telec16/cardmeter/README.md

# Cardmeter

The pleasure of having a multimeter in your pocket !
