telec16/cardmeter/ltspice/frontend.asc

C1: cap; 100n
R1: res; 5k
R2: res; {Rdiv}
R3: res; 1
R4: res; 470k
R5: res; 100k
R6: res; 100k
R7: res; 100k
R8: res; 100k
R9: res; 100k
U1: AD8235
U2: LTC1992
V1: voltage; SINE(0 2 50)
V2: voltage; 3.3
V3: voltage; {Vref}
Named nets: 0, REF, vcc, out, out+, out-
.tran 100ms
.step param Vref list 0 .5 .75 1 1.25 1.5 1.85
.param Rdiv 10k
.param Vref 1.75
.step param Rdiv list 1k 10k
