telec16/cardmeter/ltspice/frontend_bis.asc

R1: res; 22k
R2: res; 10k
R3: res; 1
R4: res; 470k
R5: res; 100k
U1: AD8235
V1: voltage; SINE(0 2 50)
V2: voltage; 3.3
V3: voltage; {2.048/2}
Named nets: 0, vcc, out, out+, out-, REF
.tran 100ms
