telec16/cardmeter/kicad/cardV5.kicad_pcb

## KiCad design kicad/cardV5.kicad_pcb (2020-05-11)

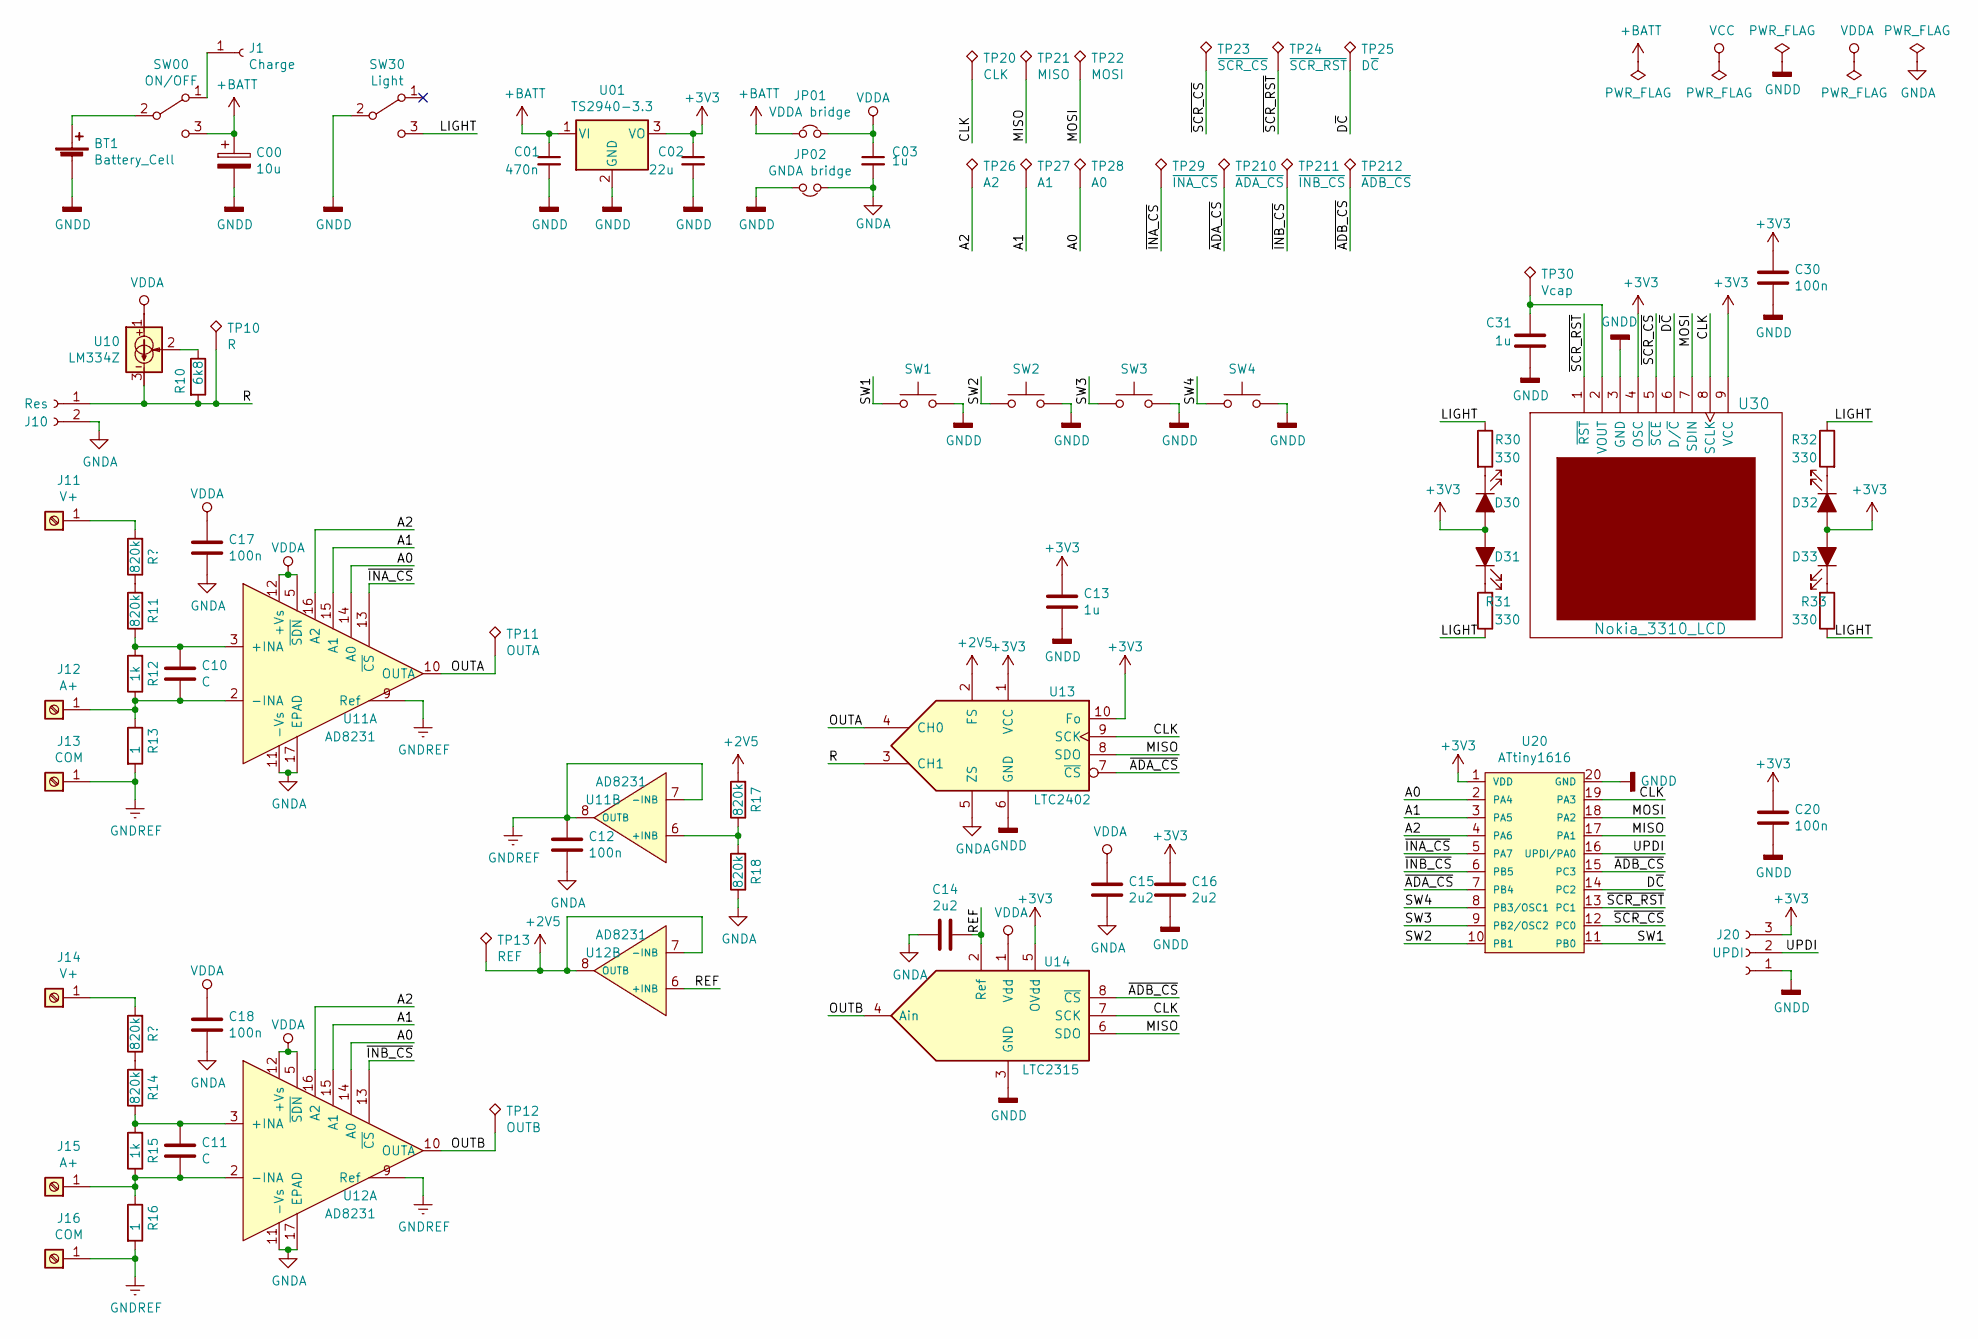
[picture p1: schematic cardV5.sch]

Parts:
BT1: Battery_Cell; LiPO_150m
C00: 10u; CP_Elec_3x5.4
C01: 470n; C_0805_2012Metric_Pad1.15x1.40mm_HandSolder
C02: 22u; C_0805_2012Metric_Pad1.15x1.40mm_HandSolder
C03, C31: 1u; C_0805_2012Metric_Pad1.15x1.40mm_HandSolder
C10, C11: C; C_0805_2012Metric_Pad1.15x1.40mm_HandSolder
C12, C17, C18, C20, C30: 100n; C_0805_2012Metric_Pad1.15x1.40mm_HandSolder
C13: 1u; C_1206_3216Metric_Pad1.42x1.75mm_HandSolder
C14, C15, C16: 2u2; C_1206_3216Metric_Pad1.42x1.75mm_HandSolder
D30, D31, D32, D33: LED_ALT; LED_0805_2012Metric_Pad1.15x1.40mm_HandSolder
J1: Charge; PinSocket_1x01_P2.54mm_Vertical
J10: Res; PinSocket_1x02_P2.54mm_Vertical
J11, J14: V+; Probing_pad
J12, J15: A+; Probing_pad
J13, J16: COM; Probing_pad
J20: UPDI; PinSocket_1x03_P2.54mm_Horizontal
JP01: VDDA bridge; SolderJumper-2_P1.3mm_Bridged_Pad1.0x1.5mm
JP02: GNDA bridge; SolderJumper-2_P1.3mm_Bridged_Pad1.0x1.5mm
R10: 6k8; R_0805_2012Metric_Pad1.15x1.40mm_HandSolder
R11, R14, R17, R18: 820k; R_0805_2012Metric_Pad1.15x1.40mm_HandSolder
R12, R15: 1k; R_0805_2012Metric_Pad1.15x1.40mm_HandSolder
R13, R16: 1; R_1210_3225Metric_Pad1.42x2.65mm_HandSolder
R30, R31, R32, R33: 330; R_0805_2012Metric_Pad1.15x1.40mm_HandSolder
SW00: ON/OFF; PinHeader_1x03_P2.54mm_Vertical
SW1, SW2, SW3, SW4: SW_Push; SW_SPST_EVQQ2
SW30: Light; PinHeader_1x03_P2.54mm_Vertical
TP10: R; Probing_pad
TP11: OUTA; Probing_pad
TP12: OUTB; Probing_pad
TP13: REF; Probing_pad
TP20: CLK; Probing_pad
TP21: MISO; Probing_pad
TP22: MOSI; Probing_pad
TP23: ~SCR_CS; Probing_pad
TP24: ~SCR_RST; Probing_pad
TP25: D~C; Probing_pad
TP26: A2; Probing_pad
TP27: A1; Probing_pad
TP28: A0; Probing_pad
TP29: ~INA_CS; Probing_pad
TP30: Vcap; Probing_pad
TP210: ~ADA_CS; Probing_pad
TP211: ~INB_CS; Probing_pad
TP212: ~ADB_CS; Probing_pad
U01: TS2940-3.3; SOT-223-3_TabPin2
U10: LM334Z; TO-92_Inline_Wide
U11, U12: AD8231; LFCSP-16-1EP_4x4mm_P0.65mm_EP2.1x2.1mm
U13: LTC2402; MSOP-10_3x3mm_P0.5mm
U14: LTC2315; TSOT-23-8_HandSoldering
U20: ATtiny1616; SOIC-20W_7.5x12.8mm_P1.27mm
U30: Nokia_3310_LCD; NOKIA_3310_LCD

Connections:
+2V5: R17.2, TP13.1, U12.7 (-INB), U12.8 (OUTB), U13.2 (FS)
+3V3: C02.1, C13.2, C16.2, C20.1, C30.1, D30.2 (A), D31.2 (A), D32.2 (A), D33.2 (A), J20.3, U01.3 (VO), U13.1 (VCC), U13.10 (Fo), U14.5 (OVdd), U20.1 (VDD), U30.4 (OSC), U30.9 (VCC)
+BATT: C00.1, C01.1, JP01.1, SW00.3 (C), U01.1 (VI)
/A0: TP28.1, U11.14 (A0), U12.14 (A0), U20.2 (PA4)
/A1: TP27.1, U11.15 (A1), U12.15 (A1), U20.3 (PA5)
/A2: TP26.1, U11.16 (A2), U12.16 (A2), U20.4 (PA6)
/CLK: TP20.1, U13.9 (SCK), U14.7 (SCK), U20.19 (PA3), U30.8 (SCLK)
/D~C: TP25.1, U20.14 (PC2), U30.6 (D/~C)
/LIGHT: R30.1, R31.1, R32.1, R33.1, SW30.3 (C)
/MISO: TP21.1, U13.8 (SDO), U14.6 (SDO), U20.17 (PA1)
/MOSI: TP22.1, U20.18 (PA2), U30.7 (SDIN)
/OUTA: TP11.1, U11.10 (OUTA), U13.4 (CH0)
/OUTB: TP12.1, U12.10 (OUTA), U14.4 (Ain)
/R: J10.1, R10.2, TP10.1, U10.3, U13.3 (CH1)
/REF: C14.1, U12.6 (+INB), U14.2 (Ref)
/SW1: SW1.1, U20.11 (PB0)
/SW2: SW2.1, U20.10 (PB1)
/SW3: SW3.1, U20.9 (PB2/OSC2)
/SW4: SW4.1, U20.8 (PB3/OSC1)
/UPDI: J20.2, U20.16 (UPDI/PA0)
/~ADA_CS: TP210.1, U13.7 (~CS), U20.7 (PB4)
/~ADB_CS: TP212.1, U14.8 (~CS), U20.15 (PC3)
/~INA_CS: TP29.1, U11.13 (~CS), U20.5 (PA7)
/~INB_CS: TP211.1, U12.13 (~CS), U20.6 (PB5)
/~SCR_CS: TP23.1, U20.12 (PC0), U30.5 (~SCE)
/~SCR_RST: TP24.1, U20.13 (PC1), U30.1 (~RST)
GNDA: C03.2, C12.2, C14.2, C15.1, C17.2, C18.2, J10.2, JP02.1, R18.1, U11.11 (-Vs), U11.17 (EPAD), U12.11 (-Vs), U12.17 (EPAD), U13.5 (ZS)
GNDD: BT1.2 (-), C00.2, C01.2, C02.2, C13.1, C16.1, C20.2, C30.2, C31.2, J20.1, JP02.2, SW1.2, SW2.2, SW3.2, SW4.2, SW30.2 (B), U01.2 (GND), U13.6 (GND), U14.3 (GND), U20.20 (GND), U30.3 (GND)
GNDREF: C12.1, J13.1, J16.1, R13.2, R16.2, U11.7 (-INB), U11.8 (OUTB), U11.9 (Ref), U12.9 (Ref)
unnamed: BT1.1 (+), SW00.2 (B)
unnamed: C10.1, R11.1, R12.2, U11.3 (+INA)
unnamed: C10.2, J12.1, R12.1, R13.1, U11.2 (-INA)
unnamed: C11.1, R14.1, R15.2, U12.3 (+INA)
unnamed: C11.2, J15.1, R15.1, R16.1, U12.2 (-INA)
unnamed: C31.1, TP30.1, U30.2 (VOUT)
unnamed: D30.1 (K), R30.2
unnamed: D31.1 (K), R31.2
unnamed: D32.1 (K), R32.2
unnamed: D33.1 (K), R33.2
unnamed: J1.1, SW00.1 (A)
unnamed: J11.1, R11.2
unnamed: J14.1, R14.2
unnamed: R10.1, U10.2
unnamed: R17.1, R18.2, U11.6 (+INB)
VDDA: C03.1, C15.2, C17.1, C18.1, JP01.2, U10.1, U11.5 (~SDN), U11.12 (+Vs), U12.5 (~SDN), U12.12 (+Vs), U14.1 (Vdd)

Board: 2 copper layers, 77 parts (10 on the bottom side), 45 nets, no tracks yet.
