telec16/cardmeter/kicad/cardV4.kicad_pcb

## KiCad design kicad/cardV4.kicad_pcb (2020-05-11, an earlier design)

Schematic: cardV4.sch

Parts:
BT1: Battery_Cell; BatteryHolder_Keystone_103_1x20mm
C00: 10u; CP_Elec_3x5.4
C01: 470n; C_0805_2012Metric_Pad1.15x1.40mm_HandSolder
C02: 22u; C_0805_2012Metric_Pad1.15x1.40mm_HandSolder
C03, C31: 1u; C_0805_2012Metric_Pad1.15x1.40mm_HandSolder
C04, C10, C11, C12, C20, C30: 100n; C_0805_2012Metric_Pad1.15x1.40mm_HandSolder
C13, C14: 33p; C_0805_2012Metric_Pad1.15x1.40mm_HandSolder
D30, D31, D32, D33: LED_ALT; LED_0805_2012Metric_Pad1.15x1.40mm_HandSolder
J1: Charge; PinSocket_1x01_P2.54mm_Vertical
J10: AOP; PinSocket_1x03_P1.27mm_Vertical
J11: Volt1; PinSocket_1x02_P2.54mm_Vertical
J12: Volt2; PinSocket_1x02_P2.54mm_Vertical
J13: Amp; PinSocket_1x02_P2.54mm_Vertical
J14: Res; PinSocket_1x02_P2.54mm_Vertical
J20: UPDI; PinSocket_1x03_P2.54mm_Horizontal
JP01: VDDA bridge; SolderJumper-2_P1.3mm_Bridged_Pad1.0x1.5mm
JP02: GNDA bridge; SolderJumper-2_P1.3mm_Bridged_Pad1.0x1.5mm
JP20, JP21, JP22: SolderJumper_2_Bridged; SolderJumper-2_P1.3mm_Bridged_Pad1.0x1.5mm
R10, R11: 100k; R_0805_2012Metric_Pad1.15x1.40mm_HandSolder
R12, R14: 820k; R_0805_2012Metric_Pad1.15x1.40mm_HandSolder
R13, R15: 1k; R_0805_2012Metric_Pad1.15x1.40mm_HandSolder
R16: 1; R_1210_3225Metric_Pad1.42x2.65mm_HandSolder
R17: 6k8; R_0805_2012Metric_Pad1.15x1.40mm_HandSolder
R30, R31, R32, R33: 330; R_0805_2012Metric_Pad1.15x1.40mm_HandSolder
SW00, SW30: ON/OFF; PinHeader_1x03_P2.54mm_Vertical
SW1, SW2, SW3, SW4: SW_Push; SW_SPST_EVQQ2
TP10: Ref; Probing_pad
TP11: V1; Probing_pad
TP12: V2; Probing_pad
TP14: R; Probing_pad
TP20: CLK; Probing_pad
TP21: MISO; Probing_pad
TP22: MOSI; Probing_pad
TP23: ~ADC_CS; Probing_pad
TP24: ~SCR_CS; Probing_pad
TP25: ~ADC_RST; Probing_pad
TP26: ~SCR_RST; Probing_pad
TP27: ~STANDBY; Probing_pad
TP28: ~RDY; Probing_pad
TP29: ~SYNC; Probing_pad
TP30: Vcap; Probing_pad
TP130: I+; Probing_pad
TP131: I-; Probing_pad
TP210: D~C; Probing_pad
U01: TS2940-3.3; SOT-223-3_TabPin2
U02: ADR291GT9Z; TO-92_Inline_Wide
U10: LT1178; SOIC-8_3.9x4.9mm_P1.27mm
U11: LM334Z; TO-92_Inline_Wide
U12: AD7731; SOIC-24W_7.5x15.4mm_P1.27mm
U20: ATtiny1616; SOIC-20W_7.5x12.8mm_P1.27mm
U30: Nokia_3310_LCD; NOKIA_3310_LCD
Y10: 4.9152MHz; Crystal_HC49-4H_Vertical

Connections:
+2V5: C04.1, U02.3, U12.14
+3V3: C02.1, C20.1, C30.1, D30.2 (A), D31.2 (A), D32.2 (A), D33.2 (A), J20.3, U01.3 (VO), U12.4, U12.23, U20.1 (VDD), U30.4 (OSC), U30.9 (VCC)
+BATT: C00.1, C01.1, JP01.1, SW00.3 (C), U01.1 (VI)
/CLK: TP20.1, U12.1, U20.19 (PA3), U30.8 (SCLK)
/D~C: TP210.1, U20.15 (PC3), U30.6 (D/~C)
/I+: J13.2, R16.1, TP130.1, U12.12
/I-: J13.1, R16.2, TP131.1, U12.13
/LIGHT: R30.1, R31.1, R32.1, R33.1, SW30.3 (C)
/MISO: TP21.1, U12.21, U20.17 (PA1)
/MOSI: TP22.1, U12.22, U20.18 (PA2), U30.7 (SDIN)
/R: J14.1, R17.2, TP14.1, U11.3, U12.16
/SW1: SW1.1, U20.11 (PB0)
/SW2: SW2.1, U20.10 (PB1)
/SW3: SW3.1, U20.9 (PB2/OSC2)
/SW4: SW4.1, U20.8 (PB3/OSC1)
/UPDI: J20.2, U20.16 (UPDI/PA0)
/V1: R12.2, R13.2, TP11.1, U12.10
/V2: R14.2, R15.2, TP12.1, U12.11
/~ADC_CS: TP23.1, U12.19, U20.3 (PA5)
/~ADC_RST: TP25.1, U12.6, U20.5 (PA7)
/~RDY: JP21.1 (A), TP28.1, U12.20
/~SCR_CS: TP24.1, U20.13 (PC1), U30.5 (~SCE)
/~SCR_RST: TP26.1, U20.14 (PC2), U30.1 (~RST)
/~STANDBY: JP22.1 (A), TP27.1, U12.18
/~SYNC: JP20.1 (A), TP29.1, U12.5
GNDA: C03.2, C04.2, C10.2, C11.2, C12.2, J14.2, JP02.1, R11.2, U02.2, U10.2, U12.8, U12.15, U12.17
GNDD: BT1.2 (-), C00.2, C01.2, C02.2, C13.1, C14.2, C20.2, C30.2, C31.2, J20.1, JP02.2, SW1.2, SW2.2, SW3.2, SW4.2, SW30.2 (B), U01.2 (GND), U12.24, U20.20 (GND), U30.3 (GND)
GNDREF: C11.1, J11.1, J12.2, R13.1, R15.1, TP10.1, U10.7, U10.8
unnamed: BT1.1 (+), SW00.2 (B)
unnamed: C13.2, U12.3, Y10.2
unnamed: C14.1, U12.2, Y10.1
unnamed: C31.1, TP30.1, U30.2 (VOUT)
unnamed: D30.1 (K), R30.2
unnamed: D31.1 (K), R31.2
unnamed: D32.1 (K), R32.2
unnamed: D33.1 (K), R33.2
unnamed: J1.1, SW00.1 (A)
unnamed: J10.1, U10.3
unnamed: J10.2, U10.4
unnamed: J10.3, U10.5
unnamed: J11.2, R12.1
unnamed: J12.1, R14.1
unnamed: JP20.2 (B), U20.6 (PB5)
unnamed: JP21.2 (B), U20.4 (PA6)
unnamed: JP22.2 (B), U20.2 (PA4)
unnamed: R10.2, R11.1, U10.1
unnamed: R17.1, U11.2
VDDA: C03.1, C10.1, C12.1, JP01.2, R10.1, U02.1, U10.6, U11.1, U12.9

Notes on the sheet:
Low-to-High Write Clock idle High
5pF
13pF

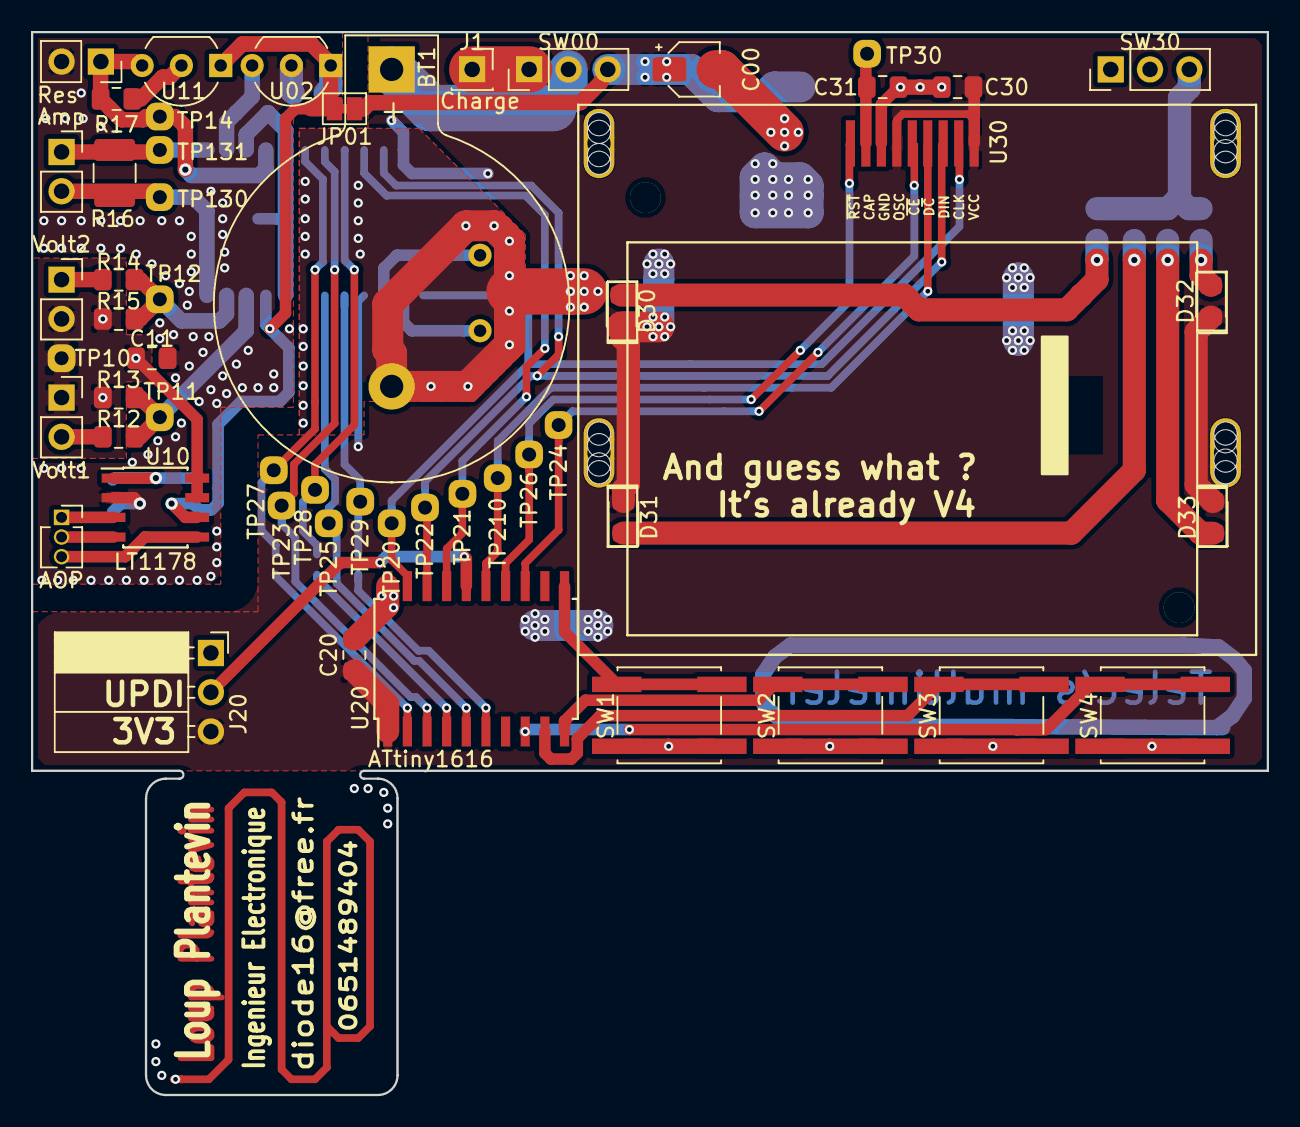
[picture p2: board cardV4.kicad_pcb from above]

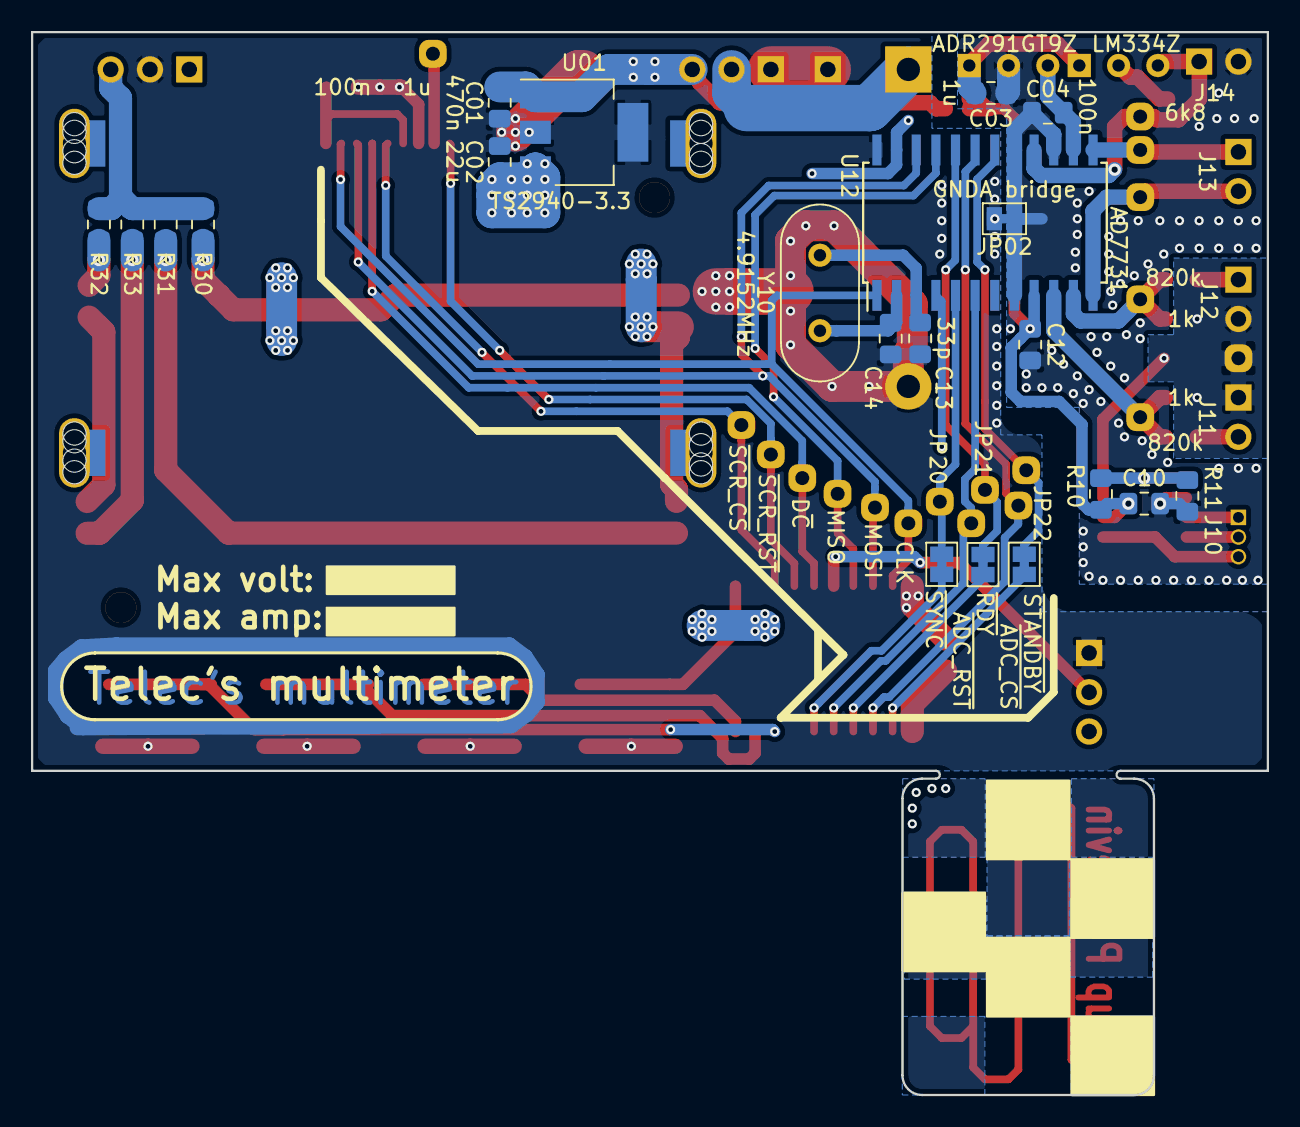
[picture p3: board cardV4.kicad_pcb from below]

Board: 2 copper layers, 79.9 x 68.7 mm, 74 parts (21 on the bottom side), 48 nets.
