telec16/cardmeter/kicad/CardMeterFrontEnd.kicad_pcb

## KiCad design kicad/CardMeterFrontEnd.kicad_pcb (2020-01-23)

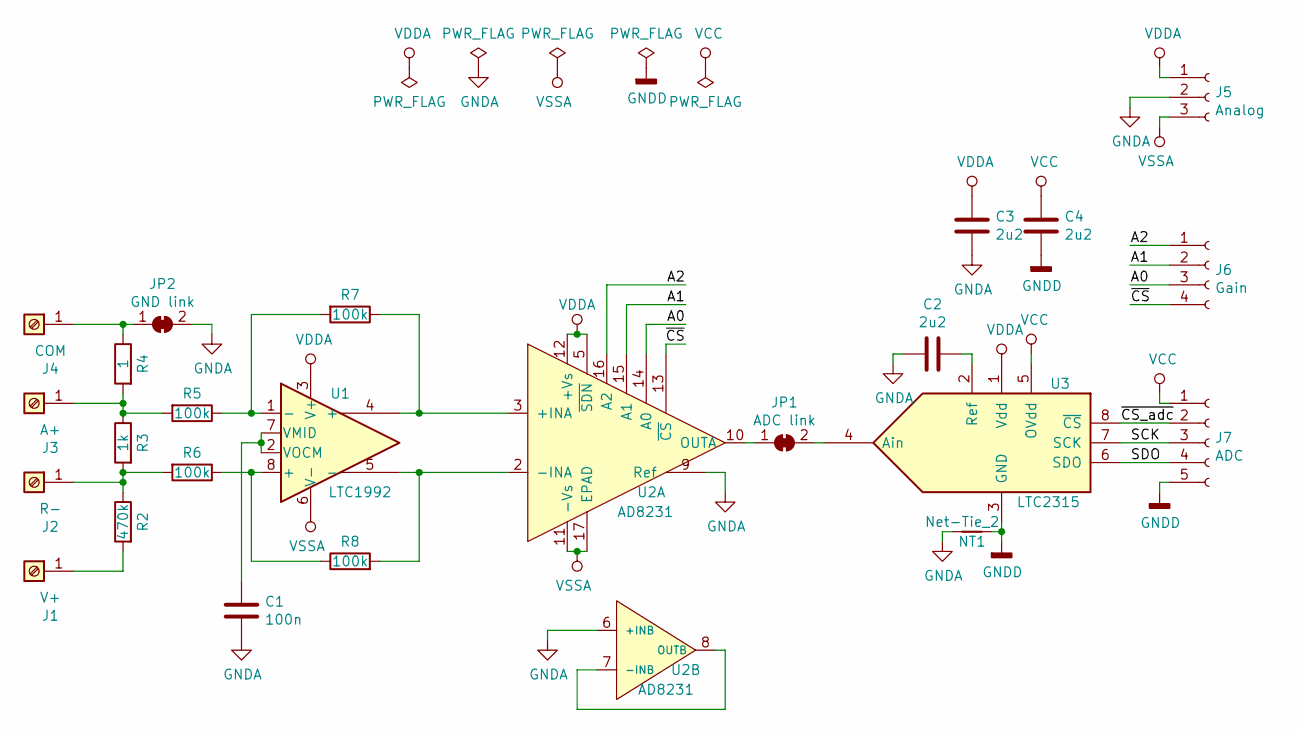
[picture p4: schematic CardMeterFrontEnd.sch]

Parts:
C1: 100n; C_0805_2012Metric_Pad1.15x1.40mm_HandSolder
C2, C3, C4: 2u2; C_1206_3216Metric_Pad1.42x1.75mm_HandSolder
J1: V+; Probing_pad
J2: R-; Probing_pad
J3: A+; Probing_pad
J4: COM; Probing_pad
J5: Analog; PinHeader_1x03_P1.27mm_Vertical
J6: Gain; PinHeader_1x04_P1.27mm_Vertical
J7: ADC; PinHeader_1x05_P1.27mm_Vertical
JP1: ADC link; SolderJumper-2_P1.3mm_Open_TrianglePad1.0x1.5mm
JP2: GND link; SolderJumper-2_P1.3mm_Open_TrianglePad1.0x1.5mm
NT1: Net-Tie_2; NetTie-2_SMD_Pad0.5mm
R2: 470k; R_0805_2012Metric_Pad1.15x1.40mm_HandSolder
R3: 1k; R_0805_2012Metric_Pad1.15x1.40mm_HandSolder
R4: 1; R_1206_3216Metric_Pad1.42x1.75mm_HandSolder
R5, R6, R7, R8: 100k; R_0805_2012Metric_Pad1.15x1.40mm_HandSolder
U1: LTC1992; MSOP-8_3x3mm_P0.65mm
U2: AD8231; LFCSP-16-1EP_4x4mm_P0.65mm_EP2.1x2.1mm
U3: LTC2315; TSOT-23-8_HandSoldering

Connections:
/A0: J6.3, U2.14 (A0)
/A1: J6.2, U2.15 (A1)
/A2: J6.1, U2.16 (A2)
/SCK: J7.3, U3.7 (SCK)
/SDO: J7.4, U3.6 (SDO)
/~CS: J6.4, U2.13 (~CS)
/~CS_adc: J7.2, U3.8 (~CS)
GNDA: C1.2, C2.2, C3.1, J5.2, JP2.2 (B), NT1.1, U2.6 (+INB), U2.9 (Ref)
GNDD: C4.1, J7.5, NT1.2, U3.3 (GND)
unnamed: C1.1, U1.2 (VOCM), U1.7 (VMID)
unnamed: C2.1, U3.2 (Ref)
unnamed: J1.1, R2.2
unnamed: J2.1, R2.1, R3.2, R6.2
unnamed: J3.1, R3.1, R4.2, R5.2
unnamed: J4.1, JP2.1 (A), R4.1
unnamed: JP1.1 (A), U2.10 (OUTA)
unnamed: JP1.2 (B), U3.4 (Ain)
unnamed: R5.1, R7.2, U1.1 (-)
unnamed: R6.1, R8.1, U1.8 (+)
unnamed: R7.1, U1.4 (+), U2.3 (+INA)
unnamed: R8.2, U1.5 (-), U2.2 (-INA)
unnamed: U2.7 (-INB), U2.8 (OUTB)
VCC: C4.2, J7.1, U3.5 (OVdd)
VDDA: C3.2, J5.1, U1.3 (V+), U2.5 (~SDN), U2.12 (+Vs), U3.1 (Vdd)
VSSA: J5.3, U1.6 (V-), U2.11 (-Vs), U2.17 (EPAD)

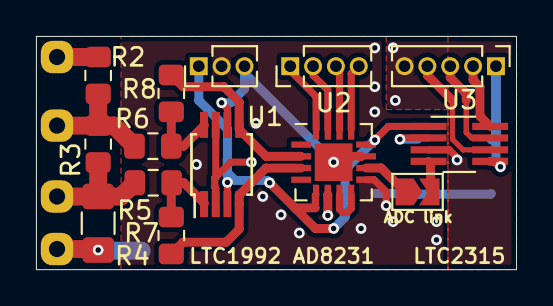
[picture p5: board CardMeterFrontEnd.kicad_pcb from above]

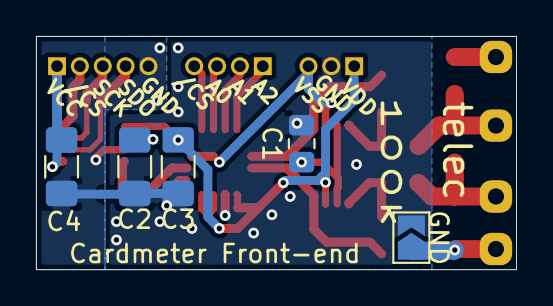
[picture p6: board CardMeterFrontEnd.kicad_pcb from below]

Board: 2 copper layers, 26.7 x 13.0 mm, 24 parts (6 on the bottom side), 25 nets.
