telec16/cardmeter/eagle/cardV2.brd

## EAGLE design eagle/cardV2.brd (2018-05-07, an earlier design)

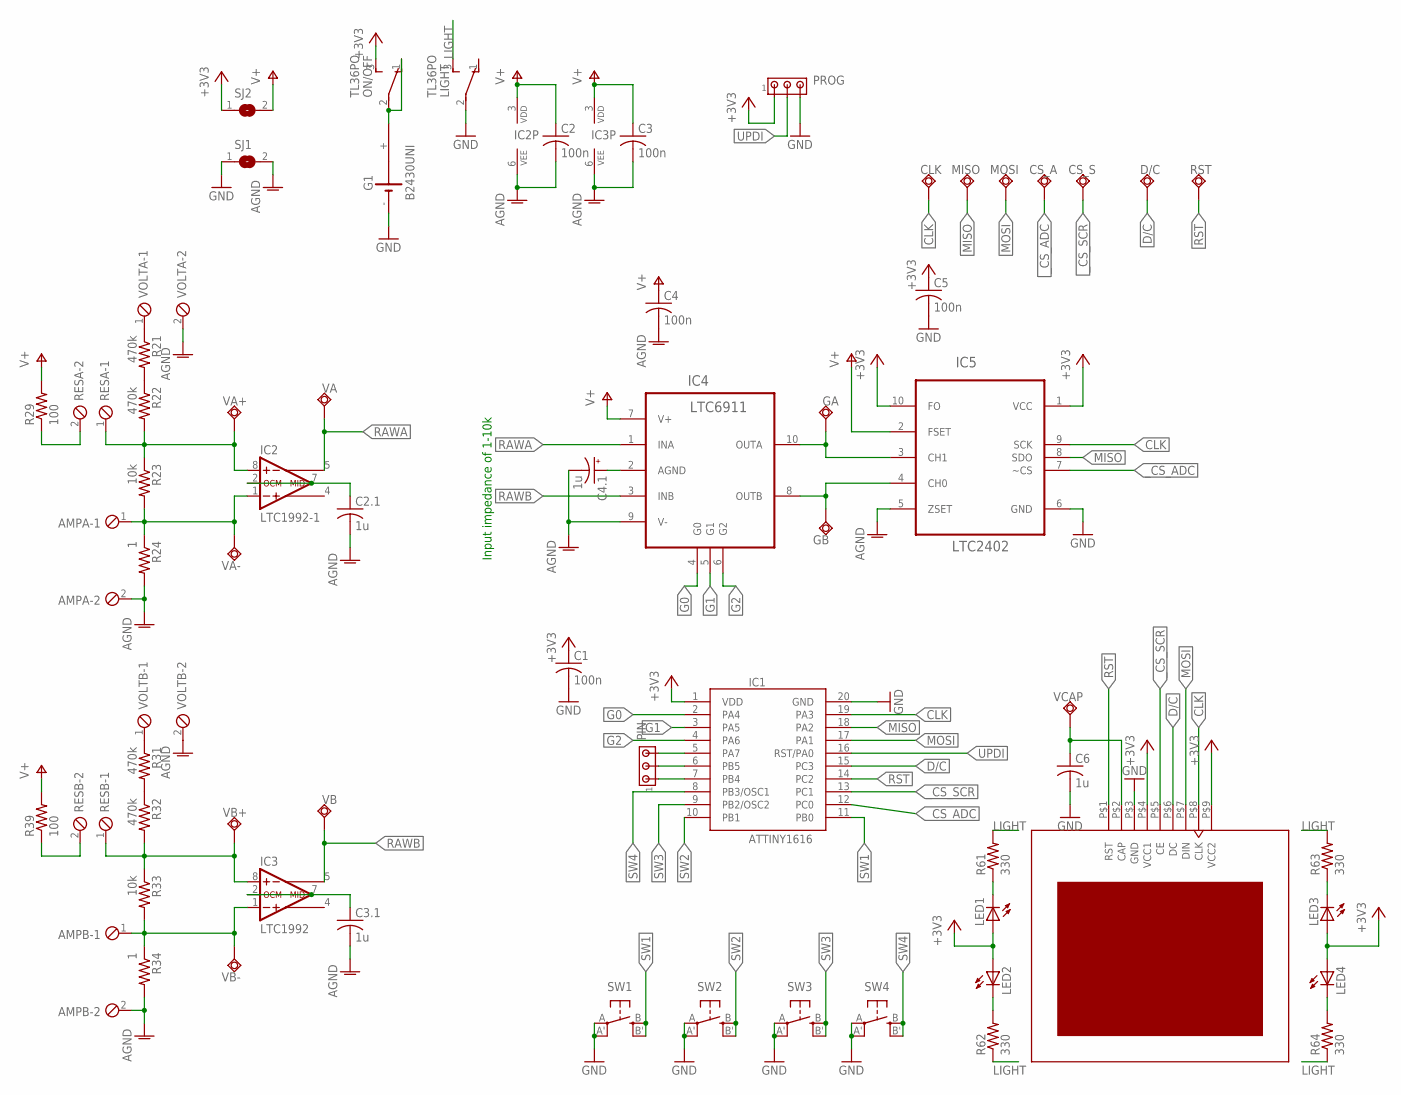
[picture p7: schematic cardV2.sch]

Parts:
AMPA: MPT2; 2POL254
AMPB: MPT2; 2POL254
C1, C2, C3, C4, C5: 100n; C0805K
C2.1, C3.1, C6: 1u; C0805
C4.1: 1u; A/3216-18R
CLK: TPSQB1,27; B1,27
CS_A: TPSQB1,27; B1,27
CS_S: TPSQB1,27; B1,27
D/C: TPSQB1,27; B1,27
G1: B2430UNI
GA: TPSQB1,27; B1,27
GB: TPSQB1,27; B1,27
IC1: ATTINY1616; SO20W
IC2: LTC1992-1; MSOP8
IC3: LTC1992; MSOP8
IC4: LTC6911; MSOP10
IC5: LTC2402; MSOP10
LED1, LED2, LED3, LED4: LEDCHIP-LED0805; CHIP-LED0805
LIGHT: TL36PO; TL3XPO
MISO: TPSQB1,27; B1,27
MOSI: TPSQB1,27; B1,27
ON/OFF: TL36PO; TL3XPO
PIN: MTA03-100; 10X03MTA
PROG: MTA03-100; 10X03MTA
R21, R22, R31, R32: 470k; M0805
R23, R33: 10k; M0805
R24, R34: 1; M0805
R29, R39: 100; M0805
R61, R62, R63, R64: 330; M0805
RESA: MPT2; 2POL254
RESB: MPT2; 2POL254
RST: TPSQB1,27; B1,27
SJ1, SJ2: SJ
SW1, SW2, SW3, SW4: SPST_TACT-EVQQ2; EVQ-Q2
U$1: NOKIA_SCREEN
VA: TPSQB1,27; B1,27
VA+: TPSQB1,27; B1,27
VA-: TPSQB1,27; B1,27
VB: TPSQB1,27; B1,27
VB+: TPSQB1,27; B1,27
VB-: TPSQB1,27; B1,27
VCAP: TPSQB1,27; B1,27
VOLTA: MPT2; 2POL254
VOLTB: MPT2; 2POL254

Connections:
+3V3: C1.1, C5.1, IC1.1 (VDD), IC5.1 (VCC), IC5.10 (FO), LED1.A, LED2.A, LED3.A, LED4.A, ON/OFF.3 (S), PROG.1, SJ2.1, U$1.P$4 (VCC1), U$1.P$9 (VCC2)
AGND: AMPA.2, AMPB.2, C2.2, C2.1.2, C3.2, C3.1.2, C4.2, C4.1.-, IC2.6 (VEE), IC3.6 (VEE), IC4.9 (V-), IC5.5 (ZSET), R24.2, R34.2, SJ1.2, VOLTA.2, VOLTB.2
CLK: CLK.TP, IC1.19 (PA3), IC5.9 (SCK), U$1.P$8 (CLK)
D/C: D/C.TP, IC1.15 (PC3), U$1.P$6 (DC)
G0: IC1.2 (PA4), IC4.4 (G0)
G1: IC1.3 (PA5), IC4.5 (G1)
G2: IC1.4 (PA6), IC4.6 (G2)
GND: C1.2, C5.2, C6.2, G1.-, IC1.20 (GND), IC5.6 (GND), LIGHT.2, PROG.3, SJ1.1, SW1.A, SW1.A' (P1), SW2.A, SW2.A' (P1), SW3.A, SW3.A' (P1), SW4.A, SW4.A' (P1), U$1.P$3 (GND)
LIGHT: LIGHT.3 (S), R61.2, R62.1, R63.2, R64.1
MISO: IC1.18 (PA2), IC5.8 (SDO), MISO.TP
MOSI: IC1.17 (PA1), MOSI.TP, U$1.P$7 (DIN)
unnamed: G1.+, ON/OFF.1 (O), ON/OFF.2
unnamed: LED1.C, R61.1
unnamed: C6.1, U$1.P$2 (CAP), VCAP.TP
unnamed: LED2.C, R62.2
unnamed: LED4.C, R64.2
unnamed: LED3.C, R63.1
unnamed: IC1.7 (PB4), PIN.1
unnamed: IC1.5 (PA7), PIN.3
unnamed: IC1.6 (PB5), PIN.2
unnamed: AMPA.1, IC2.1 (-IN), R23.2, R24.1, VA-.TP
unnamed: IC2.8 (+IN), R22.2, R23.1, RESA.1, VA+.TP
unnamed: C4.1.+, IC4.2 (AGND)
unnamed: C2.1.1, IC2.2 (OCM), IC2.7 (MID)
unnamed: R21.2, R22.1
unnamed: AMPB.1, IC3.1 (-IN), R33.2, R34.1, VB-.TP
unnamed: IC3.8 (+IN), R32.2, R33.1, RESB.1, VB+.TP
unnamed: R21.1, VOLTA.1
unnamed: R29.1, RESA.2
unnamed: GB.TP, IC4.8 (OUTB), IC5.4 (CH0)
unnamed: C3.1.1, IC3.2 (OCM), IC3.7 (MID)
unnamed: R31.2, R32.1
unnamed: R31.1, VOLTB.1
unnamed: R39.1, RESB.2
unnamed: GA.TP, IC4.10 (OUTA), IC5.3 (CH1)
RAWA: IC2.5 (-OUT), IC4.1 (INA), VA.TP
RAWB: IC3.5 (-OUT), IC4.3 (INB), VB.TP
RST: IC1.14 (PC2), RST.TP, U$1.P$1 (RST)
SW1: IC1.11 (PB0), SW1.B (S), SW1.B' (S1)
SW2: IC1.10 (PB1), SW2.B (S), SW2.B' (S1)
SW3: IC1.9 (PB2/OSC2), SW3.B (S), SW3.B' (S1)
SW4: IC1.8 (PB3/OSC1), SW4.B (S), SW4.B' (S1)
UPDI: IC1.16 (RST/PA0), PROG.2
V+: C2.1, C3.1, C4.1, IC2.3 (VDD), IC3.3 (VDD), IC4.7 (V+), IC5.2 (FSET), R29.2, R39.2, SJ2.2
_CS_ADC: CS_A.TP, IC1.12 (PC0), IC5.7 (~CS)
_CS_SCR: CS_S.TP, IC1.13 (PC1), U$1.P$5 (CE)

Notes on the sheet:
Input impedance of 1-10k

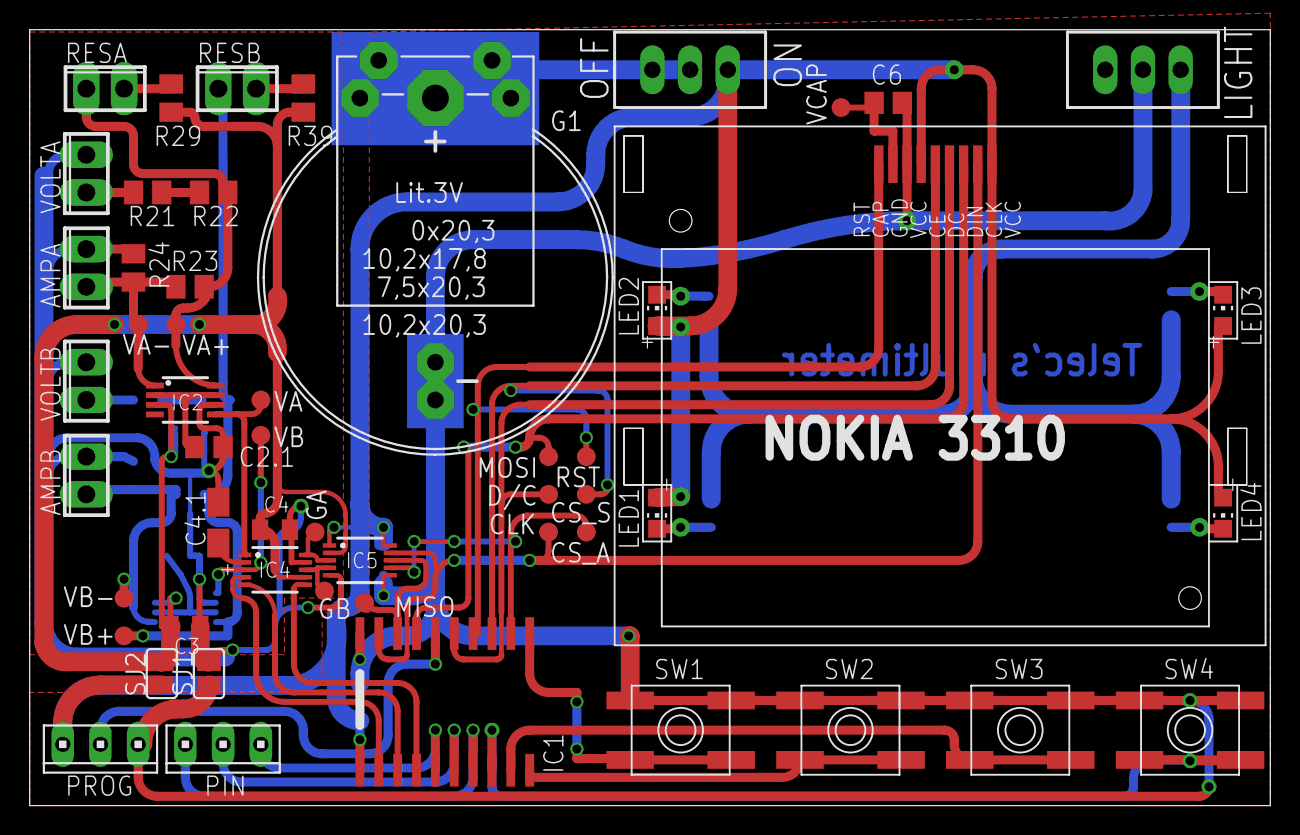
[picture p8: board cardV2.brd from above]

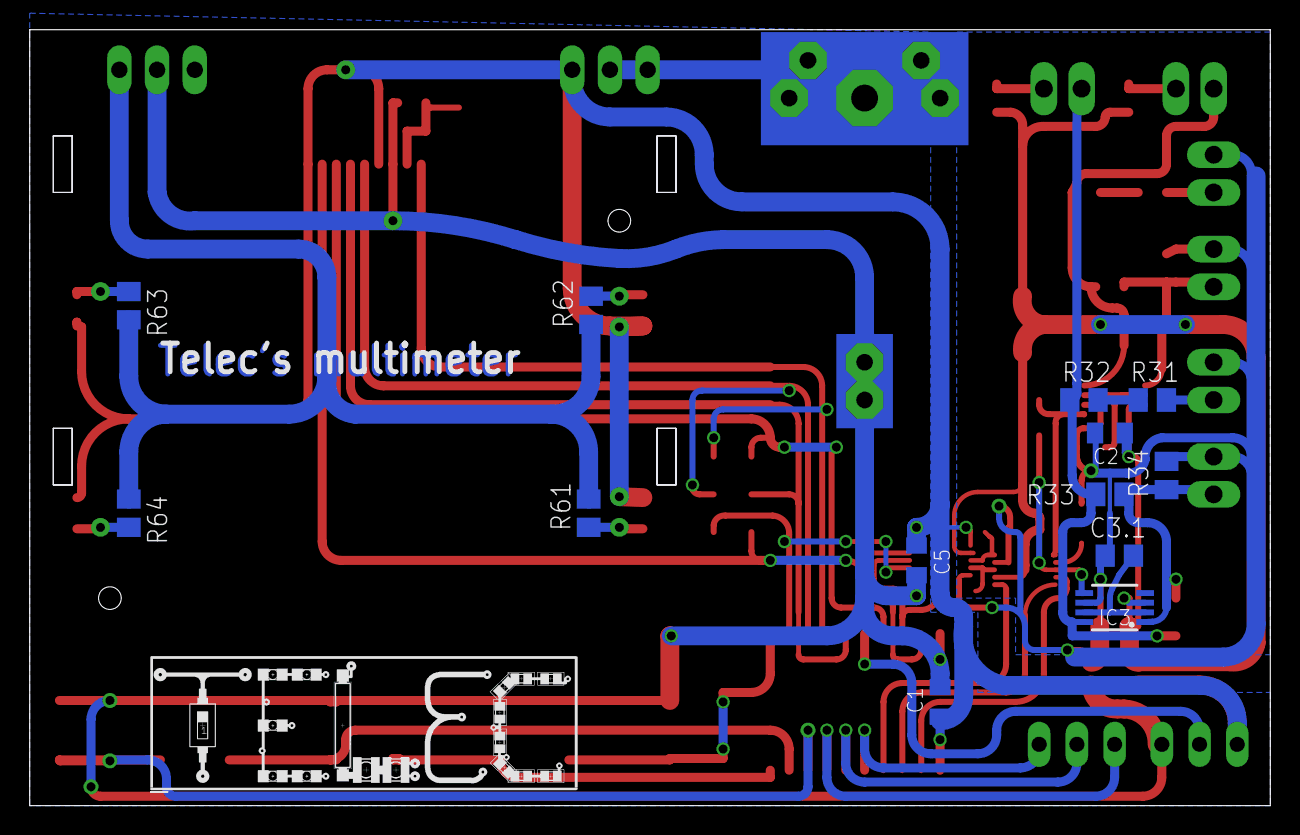
[picture p9: board cardV2.brd from below]

Board: 2 copper layers, 83.5 x 52.2 mm, 66 parts (13 on the bottom side), 46 nets.
