telec16/cardmeter/eagle/cardV3.brd

## EAGLE design eagle/cardV3.brd (2020-01-23)

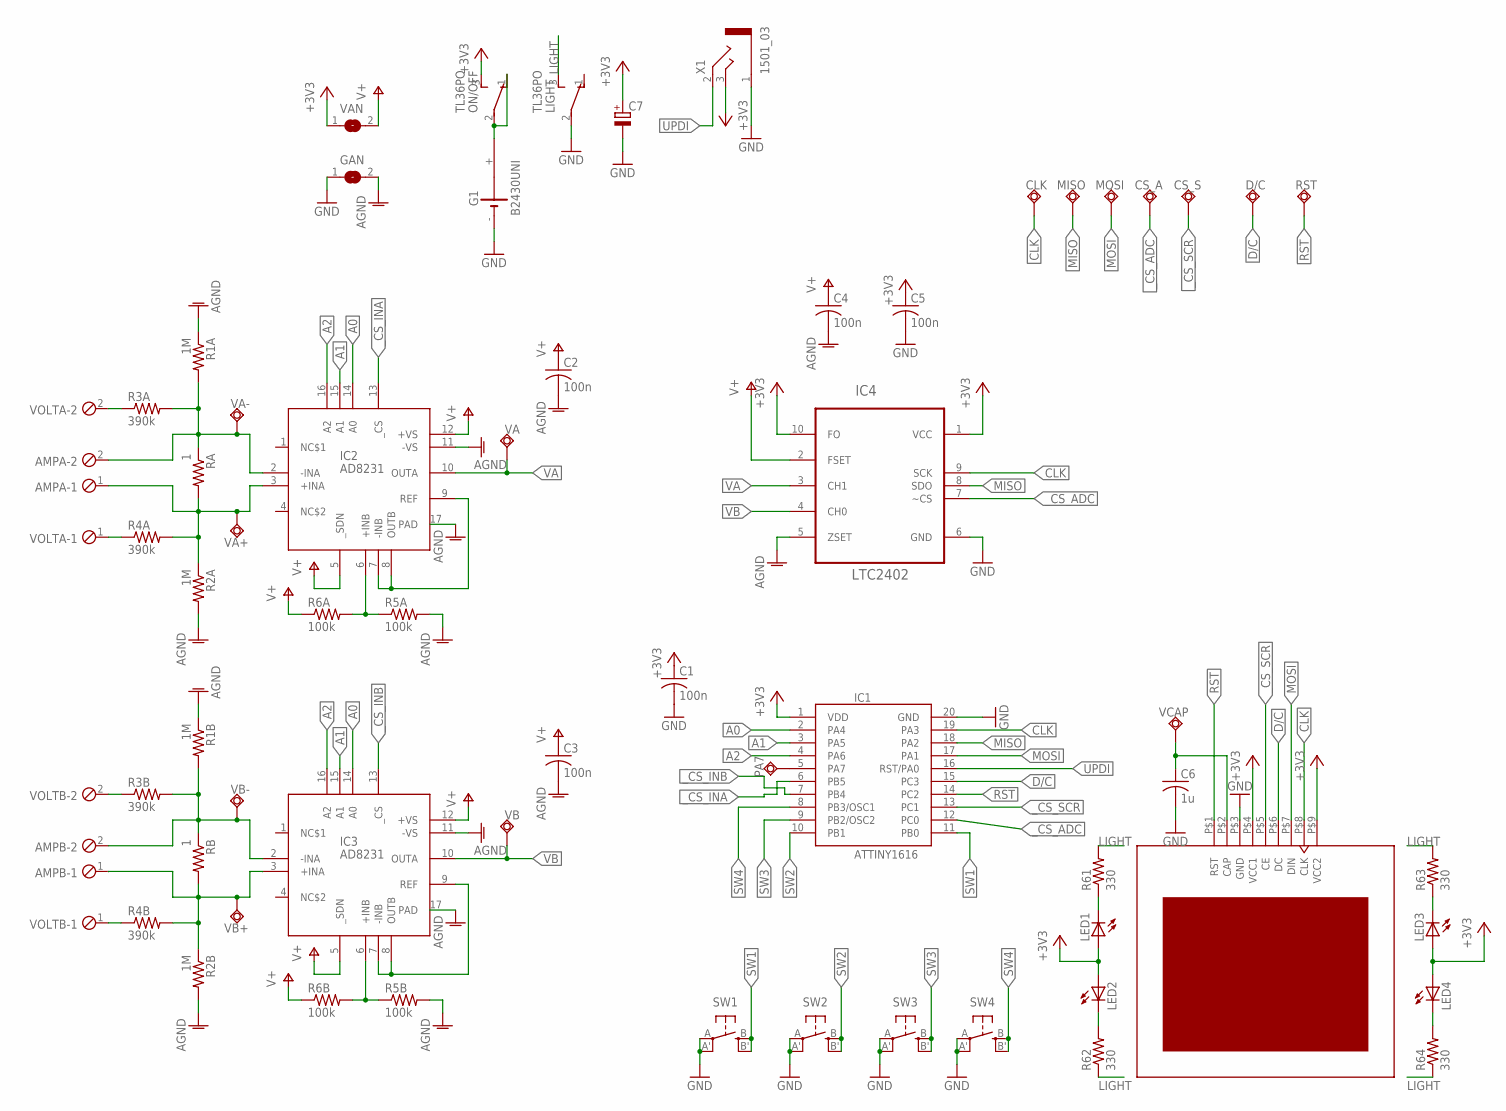
[picture p10: schematic cardV3.sch]

Parts:
AMPA: MPT2; 2POL254
AMPB: MPT2; 2POL254
C1, C2, C3, C4, C5: 100n; C0805K
C6: 1u; C0805
C7: CPOL-EU153CLV-0405; 153CLV-0405
CLK: TPSQB1,27; B1,27
CS_A: TPSQB1,27; B1,27
CS_S: TPSQB1,27; B1,27
D/C: TPSQB1,27; B1,27
G1: B2430UNI
GAN: SJ
IC1: ATTINY1616; SO20W
IC2, IC3: AD8231; LFCSP16
IC4: LTC2402; MSOP10
LED1, LED2, LED3, LED4: LEDCHIP-LED0805; CHIP-LED0805
LIGHT: TL36PO; TL3XPO
MISO: TPSQB1,27; B1,27
MOSI: TPSQB1,27; B1,27
ON/OFF: TL36PO; TL3XPO
PA7: TPSQB1,27; B1,27
R1A, R1B, R2A, R2B: 1M; M0805
R3A, R3B, R4A, R4B: 390k; M0805
R5A, R5B, R6A, R6B: 100k; M0805
R61, R62, R63, R64: 330; M0805
RA: 1; M0805
RB: 1; M0805
RST: TPSQB1,27; B1,27
SCR: NOKIA_SCREEN
SW1, SW2, SW3, SW4: SPST_TACT-EVQQ2; EVQ-Q2
VA: TPSQB1,27; B1,27
VA+: TPSQB1,27; B1,27
VA-: TPSQB1,27; B1,27
VAN: SJ
VB: TPSQB1,27; B1,27
VB+: TPSQB1,27; B1,27
VB-: TPSQB1,27; B1,27
VCAP: TPSQB1,27; B1,27
VOLTA: MPT2; 2POL254
VOLTB: MPT2; 2POL254
X1: 1501_03

Connections:
+3V3: C1.1, C5.1, C7.+, IC1.1 (VDD), IC4.1 (VCC), IC4.10 (FO), LED1.A, LED2.A, LED3.A, LED4.A, ON/OFF.3 (S), SCR.P$4 (VCC1), SCR.P$9 (VCC2), VAN.1, X1.3
A0: IC1.2 (PA4), IC2.14 (A0), IC3.14 (A0)
A1: IC1.3 (PA5), IC2.15 (A1), IC3.15 (A1)
A2: IC1.4 (PA6), IC2.16 (A2), IC3.16 (A2)
AGND: C2.2, C3.2, C4.2, GAN.2, IC2.11 (-VS), IC2.17 (PAD), IC3.11 (-VS), IC3.17 (PAD), IC4.5 (ZSET), R1A.1, R1B.1, R2A.2, R2B.2, R5A.2, R5B.2
CLK: CLK.TP, IC1.19 (PA3), IC4.9 (SCK), SCR.P$8 (CLK)
D/C: D/C.TP, IC1.15 (PC3), SCR.P$6 (DC)
GND: C1.2, C5.2, C6.2, C7.-, G1.-, GAN.1, IC1.20 (GND), IC4.6 (GND), LIGHT.2, SCR.P$3 (GND), SW1.A, SW1.A' (P1), SW2.A, SW2.A' (P1), SW3.A, SW3.A' (P1), SW4.A, SW4.A' (P1), X1.1
LIGHT: LIGHT.3 (S), R61.2, R62.1, R63.2, R64.1
MISO: IC1.18 (PA2), IC4.8 (SDO), MISO.TP
MOSI: IC1.17 (PA1), MOSI.TP, SCR.P$7 (DIN)
unnamed: G1.+, ON/OFF.1 (O), ON/OFF.2
unnamed: LED1.C, R61.1
unnamed: C6.1, SCR.P$2 (CAP), VCAP.TP
unnamed: LED2.C, R62.2
unnamed: LED4.C, R64.2
unnamed: LED3.C, R63.1
unnamed: R4A.1, VOLTA.1
unnamed: AMPB.2, IC3.2 (-INA), R1B.2, R3B.2, RB.1, VB-.TP
unnamed: AMPB.1, IC3.3 (+INA), R2B.1, R4B.2, RB.2, VB+.TP
unnamed: IC2.6 (+INB), R5A.1, R6A.2
unnamed: R3A.1, VOLTA.2
unnamed: AMPA.2, IC2.2 (-INA), R1A.2, R3A.2, RA.1, VA-.TP
unnamed: IC2.7 (-INB), IC2.8 (OUTB), IC2.9 (REF)
unnamed: AMPA.1, IC2.3 (+INA), R2A.1, R4A.2, RA.2, VA+.TP
unnamed: R3B.1, VOLTB.2
unnamed: IC3.7 (-INB), IC3.8 (OUTB), IC3.9 (REF)
unnamed: R4B.1, VOLTB.1
unnamed: IC3.6 (+INB), R5B.1, R6B.2
unnamed: IC1.5 (PA7), PA7.TP
RST: IC1.14 (PC2), RST.TP, SCR.P$1 (RST)
SW1: IC1.11 (PB0), SW1.B (S), SW1.B' (S1)
SW2: IC1.10 (PB1), SW2.B (S), SW2.B' (S1)
SW3: IC1.9 (PB2/OSC2), SW3.B (S), SW3.B' (S1)
SW4: IC1.8 (PB3/OSC1), SW4.B (S), SW4.B' (S1)
UPDI: IC1.16 (RST/PA0), X1.2
V+: C2.1, C3.1, C4.1, IC2.5 (_SDN), IC2.12 (+VS), IC3.5 (_SDN), IC3.12 (+VS), IC4.2 (FSET), R6A.1, R6B.1, VAN.2
VA: IC2.10 (OUTA), IC4.3 (CH1), VA.TP
VB: IC3.10 (OUTA), IC4.4 (CH0), VB.TP
_CS_ADC: CS_A.TP, IC1.12 (PC0), IC4.7 (~CS)
_CS_INA: IC1.6 (PB5), IC2.13 (_CS)
_CS_INB: IC1.7 (PB4), IC3.13 (_CS)
_CS_SCR: CS_S.TP, IC1.13 (PC1), SCR.P$5 (CE)

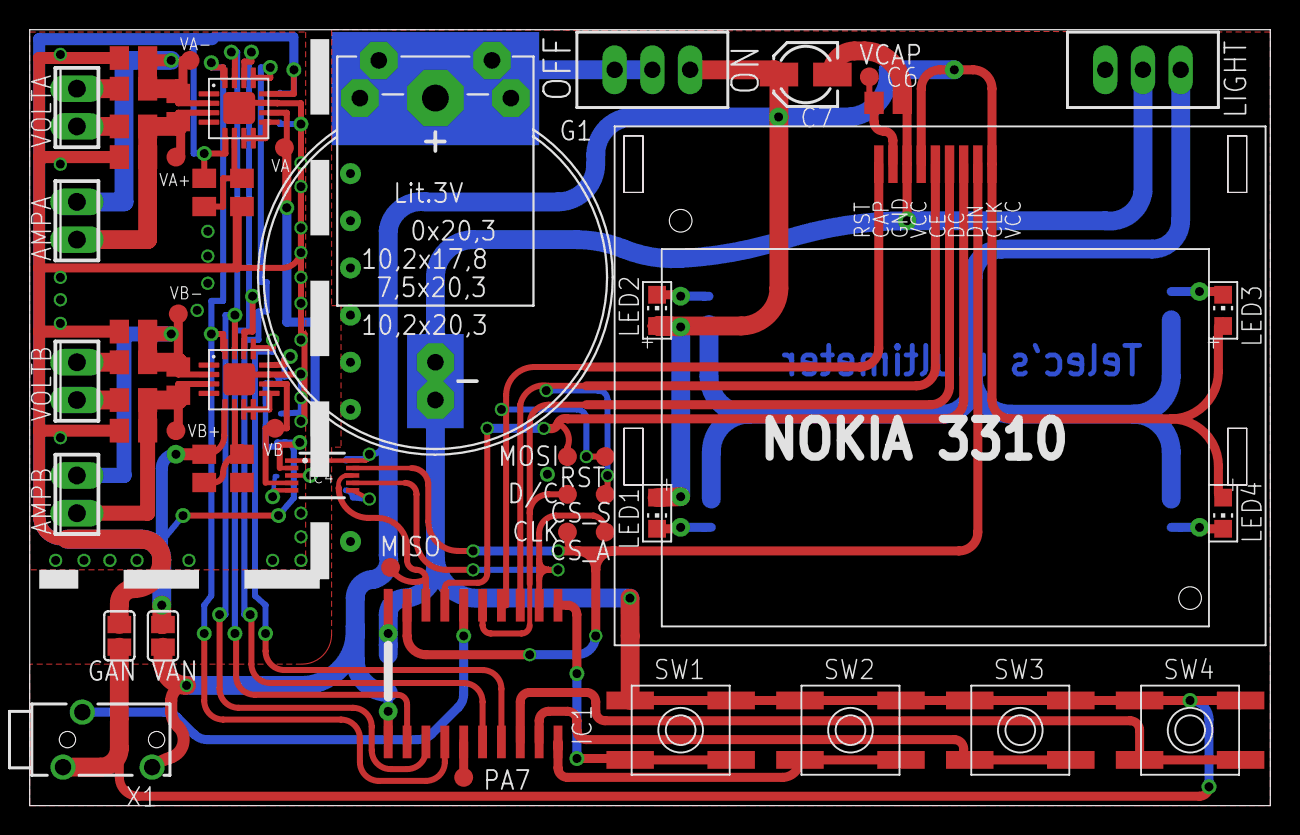
[picture p11: board cardV3.brd from above]

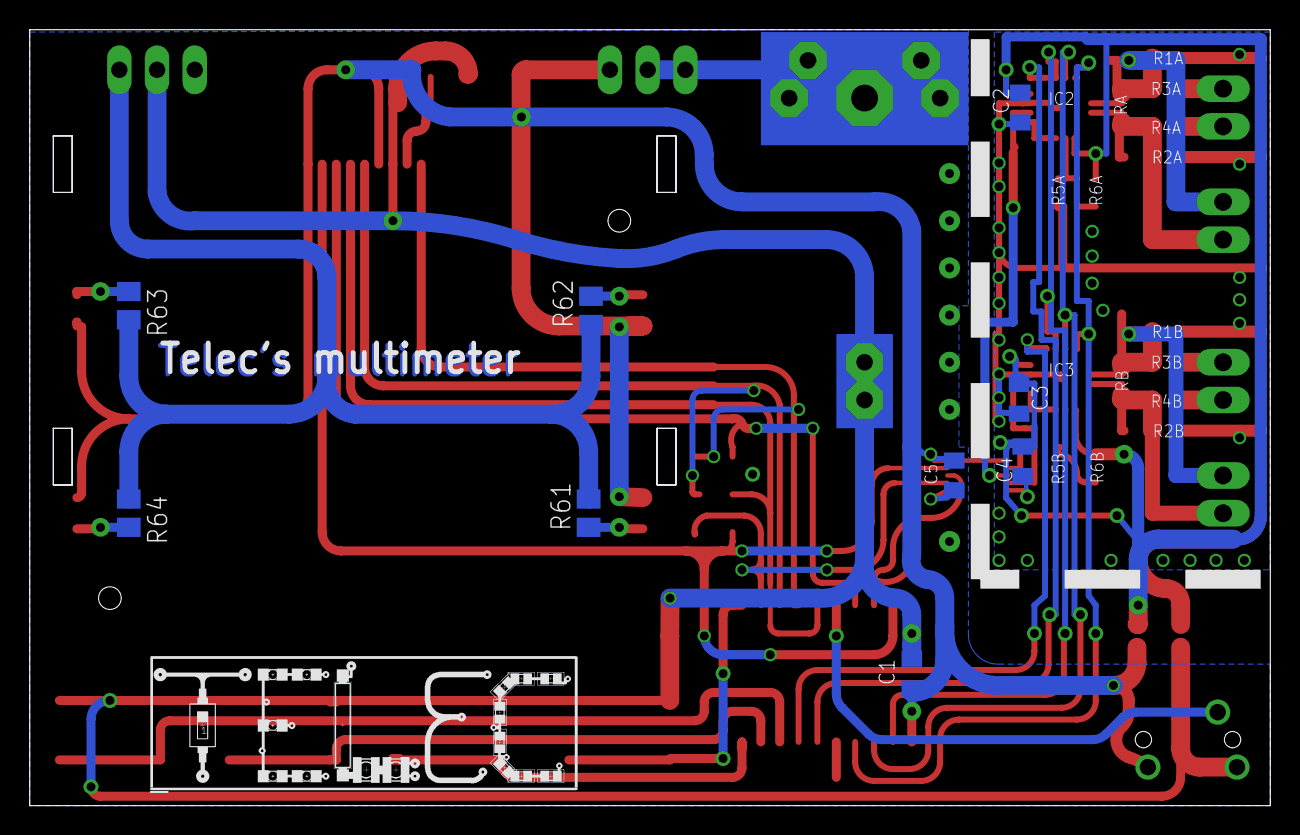
[picture p12: board cardV3.brd from below]

Board: 2 copper layers, 83.5 x 52.2 mm, 63 parts (9 on the bottom side), 43 nets.
