telec16/cardmeter/eagle/3310.brd

## EAGLE design eagle/3310.brd (2018-07-22)

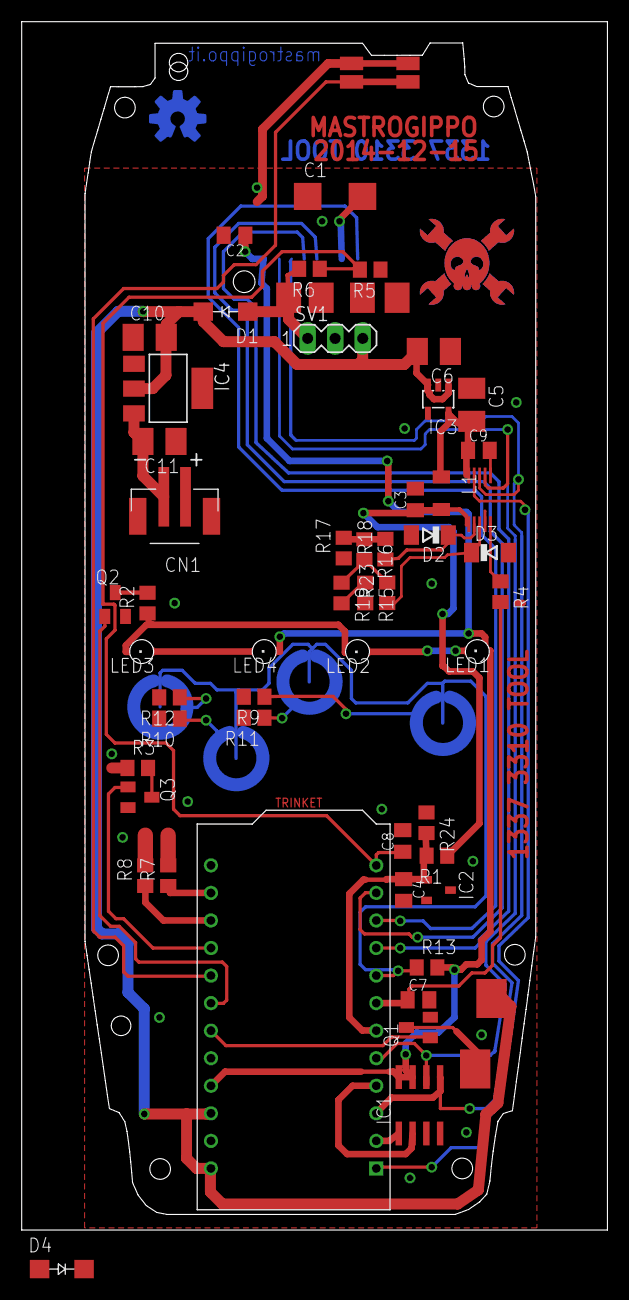
[picture p13: board 3310.brd from above]

Board: 2 copper layers, 54.0 x 111.4 mm, 52 parts (1 on the bottom side), 41 nets.

Parts:
C1: C/6032-28R
C2, C3, C4, C9: C0805K
C5, C6, C10, C11: B/3528-21R
C7: 12p; C0805K
C8: 100n; C0805K
CN1: JST-PH-2-SMT
D1, D4: GF1; SMA-DO214AC
D2, D3: 3.3; SOD80C
IC1: 25AA080SN; SO-08
IC2: LM4041; DBZ_R-PDSO-G3
IC3: TS520533; SOT25
IC4: REG1117; SOT223
L1: L3216C
LED1, LED2, LED3, LED4: CHIPLED_0603
Q1, Q2, Q3: SOT23
R1, R2, R3: R0805
R4, R5: 47k; R0805
R6: 82k; R0805
R7, R8, R9, R18, R23: 1k; R0805
R10: 2k; R0805
R11: 3k; R0805
R12: 4.7k; R0805
R13: 470; R0805
R15, R19: 470k; R0805
R16: 10k; R0805
R17: 1; R0805
R24: 100; R0805
SV1: MA03-1
U$1: 3310PANEL_NONUM; 3310BRD_NONUM
U$2: PGA113; VSSOP
U$3: TRINKET

Connections:
+3V3: C2.1, C5.+, C9.1, IC1.7, IC1.8, IC3.5, L1.1, LED1.A, LED4.A, R13.2, U$1.8, U$2.P$10, U$3.P$21
+5V: C6.+, C10.+, D1.K, D4.K, IC3.1, IC3.3, IC4.2, SV1.3, U$1.BUZ+, U$3.P$22, U$3.P$24
AMP_IN: R16.1, R17.2, R18.2
AUXLED: Q3.1, U$3.P$16
BTN: R13.1, U$1.BCI, U$1.BDI, U$1.BMI, U$1.BUI, U$3.P$8
BUZZ: Q1.1, U$3.P$19
EECS: IC1.1, U$3.P$2
GND: C1.-, C2.2, C3.2, C4.2, C5.-, C6.-, C7.2, C8.2, C9.2, C10.-, C11.-, CN1.1, D2.A, D3.A, IC1.3, IC1.4, IC2.2, IC3.2, IC4.1, Q1.2, Q2.2, Q3.2, R5.1, R9.2, R10.2, R11.2, R12.2, R17.1, SV1.2, U$1.3, U$1.BGND, U$1.BPG1, U$1.BPG2, U$1.G1, U$1.G2, U$2.P$4, U$2.P$6, U$3.P$23
LCDDE: U$1.5, U$3.P$9
LCDRES: U$1.1, U$3.P$10
LCDSC: U$1.4, U$3.P$11
LEDB: Q2.1, U$3.P$18
MISO: IC1.2, U$3.P$4
MOSI: IC1.5, U$1.6, U$2.P$8, U$3.P$3
unnamed: C1.+, U$1.2
unnamed: R4.1, U$2.P$5
unnamed: C8.1, R5.2, R6.1, U$3.P$12
unnamed: D4.A, Q1.3, U$1.BUZ-
unnamed: R8.1, U$3.P$15
unnamed: R7.1, U$3.P$14
unnamed: Q2.3, R2.2
unnamed: R9.1, U$1.BCO
unnamed: R10.1, U$1.BDO
unnamed: R11.1, U$1.BMO
unnamed: R12.1, U$1.BUO
unnamed: R15.1, R19.2
unnamed: LED1.C, LED2.A
unnamed: LED3.A, LED4.C
unnamed: LED2.C, LED3.C, R2.1
unnamed: Q3.3, R3.2
unnamed: C11.+, CN1.2, IC4.3
OPCS: U$2.P$9, U$3.P$1
OPIN1: D2.C, R18.1, U$2.P$2
OPIN2: D3.C, R23.1, U$2.P$3
OPOUT: C7.1, R4.2, U$3.P$7
PWR: U$1.BPI1, U$1.BPI2, U$3.P$17
RES_IN: R16.2, R19.1, R23.2
SCK: IC1.6, U$1.7, U$2.P$7, U$3.P$5
V+: D1.A, R6.2, SV1.1, U$1.VBATT
VCCINT: C4.1, IC2.1, R1.2, R24.2, U$3.P$6
VDD: C3.1, L1.2, R1.1, U$2.P$1
