telec16/cardmeter/firmware/CardMeter/AD8231.h

#ifndef AD8231_H_
#define AD8231_H_

#include "setup.h"
#include <avr/io.h>
#include "utils.h"

typedef enum{
	AD8231_G1,
	AD8231_G2,
	AD8231_G4,
	AD8231_G8,
	AD8231_G16,
	AD8231_G32,
	AD8231_G64,
	AD8231_G128
} AD8231_gain_t;


void AD8231_gain(AD8231_gain_t gain, pin_t csPin);


#endif /* AD8231_H_ */
