telec16/cardmeter/firmware/CardMeter/NOKIA3310.h

#ifndef NOKIA3310_H_
#define NOKIA3310_H_

#include "setup.h"
#include <avr/io.h>
#include <util/delay.h>
#include "utils.h"
#include "charset.h"

#define LCD_W 84
#define LCD_H 48
#define LCD_L 6
#define LCD_C 14
#define LCD_CW 6

#define T_VOP 0x2C
#define T_BIAS 5


void screenSetup();

void testLCD();
void changeVop(uint8_t vop);
void changeBias(uint8_t bias);

void clearLCD();
void setCoord(uint8_t x, uint8_t y);

void putChar(char chr, boolean space);
void putCharAt(char chr, uint8_t posX, uint8_t posY);
void putString(char *str, uint8_t posX, uint8_t posY);

void putPicture(uint8_t picture[], uint8_t posX, uint8_t posY, uint8_t sizeX, uint8_t sizeY);


#endif /* NOKIA3310_H_ */
