telec16/cardmeter/firmware/CardMeter/LTC2402.c

#include "LTC2402.h"

#define SCK 3 //PA3
#define SCK_P VPORTA.OUT
#define SDO 2 //PA2
#define SDO_P VPORTA.IN
#define CS 0 //PC0
#define CS_P VPORTC.OUT

void LTC2402_getData(uint32_t *ch0, uint32_t *ch1)
{
	uint32_t dat, val;
	LTC2402_channel_t chn;
	LTC2402_status_t stat;
	uint8_t i;
	
	for(i=0; i<2; i++)
	{
		while(!LTC2402_ready());
		
		dat = LTC2402_readAll();
		
		LTC2402_parse(dat, &chn, &stat, &val);
		if(chn == CH0)
			*ch0 = val;
		else
			*ch1 = val;
	}
}

boolean LTC2402_parse(uint32_t data, LTC2402_channel_t *chn, LTC2402_status_t *status, uint32_t *value)
{
	*chn = ((data>>ADC_CHN)&1) ? CH1:CH0;
	
	status->EOC = (data>>ADC_EOC) & 1;
	status->SIG = (data>>ADC_SIG) & 1;
	status->EXR = (data>>ADC_EXR) & 1;
	status->subLSBs = data & 0b1111;
	
	*value = (data>>ADC_VALUE) & 0xFFFFFF;
	
	return !status->EOC;
}

boolean LTC2402_ready()
{
	boolean r = FALSE;

	_CLR(SCK_P, SCK);
	_delay_us(1);
	_CLR(CS_P, CS);
	_delay_us(1);
	r = _GET(SDO_P, SDO); //Low if end of conversion
	_SET(CS_P, CS);

	return !r;
}

uint32_t LTC2402_readAll()
{
	uint8_t i;
	uint32_t data=0;

	_CLR(SCK_P, SCK);
	_delay_us(1);
	_CLR(CS_P, CS);

	for(i=0; i<32; i++)
	{
		_CLR(SCK_P, SCK);
		_delay_us(1);
		_SET(SCK_P, SCK);
		_delay_us(1);
		data = (data<<1) | _GET(SDO_P, SDO);
	}

	_SET(CS_P, CS);

	return data;
}
