telec16/cardmeter/(commit log)

2018-02-11 V1.0
    This seems ok
    [card.brd, card.sch]
2018-02-11 Added components values
    [card.brd, card.sch]
2018-02-16 Updated design and curved traces
    Ready to ship !
    [card.brd, card.sch]
2018-02-25 spaced a via
    [card.brd]
2018-03-10 Few changes, added logo
    [card.brd, card.sch]
2018-03-11 Added missing dimension
    [card.brd, card.sch]
2018-04-22 Something isn't working...
    [cardV1.brd, cardV1.sch, cardV2.brd, cardV2.sch]
2018-05-07 Small changes in board V2 & more test in programming
    BTW the programm works, the problem came from the not well connected LCD
    [cardV2.brd, cardV2.sch]
2018-05-07 Completly separated power lines (analog vs digital)
    And more program tests
    [cardV2.brd, cardV2.sch]
2018-05-07 Oops forget to save, see last commit
    [cardV2.brd]
2018-07-22 V3 will change everything
    [3310.brd, card.brd, card.csv, card.sch, cardV3.brd, cardV3.sch]
2018-07-22 Better V3...
    [cardV3.brd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]
2020-01-23 Restructured repo
    [3310.brd, CardMeterFrontEnd.kicad_pcb, CardMeterFrontEnd.sch, card.brd, card.csv, card.sch, cardV1.brd, cardV1.sch]
2020-01-23 front and is working
    Common Mode problem, probably due to resistor matching
    [CardMeterFrontEnd.kicad_pcb, CardMeterFrontEnd.sch]
2020-05-09 Added LTC2315 driver and some PORT/pin black magic
2020-05-09 finishing touches
    ADC is not working, more tests needed
    [AD8231.c, AD8231.h, LTC2315.c, LTC6911.c, LTC6911.h, NOKIA3310.c, NOKIA3310.h, main.c]
2020-05-10 Schematic for V5
    [CardMeterFrontEnd.sch, cardV4.kicad_pcb, cardV4.sch, cardV5.kicad_pcb, cardV5.sch]
