telec16/cardmeter/(notices)

Notices in the files:
eagle/3310.brd:
Released as Open Hardware under CC BY-SA 3.0 license
http://creativecommons.org/licenses/by-sa/3.0/legalcode
